Jakuslam/mesuring_temperature_distance_by_Arduino/držák na měřiče/drzakNaMerice.3mf

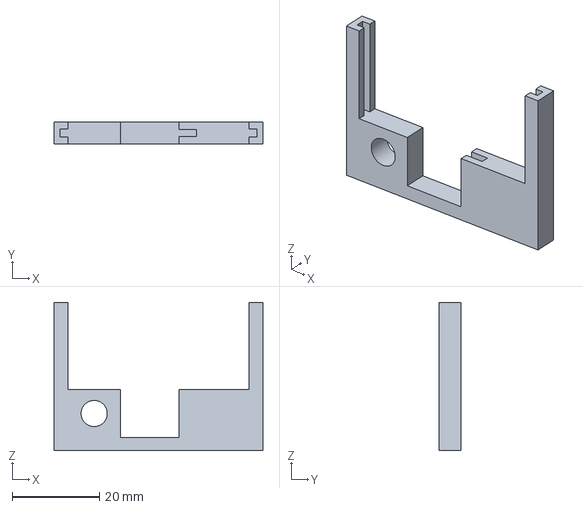
[picture p16: CAD file, 2024-05-21]
držák na měřiče/drzakNaMerice.3mf
48.0 x 5.00 x 34.0 mm
