Jakuslam/mesuring_temperature_distance_by_Arduino/měřící přístroj - case/handle.3mf

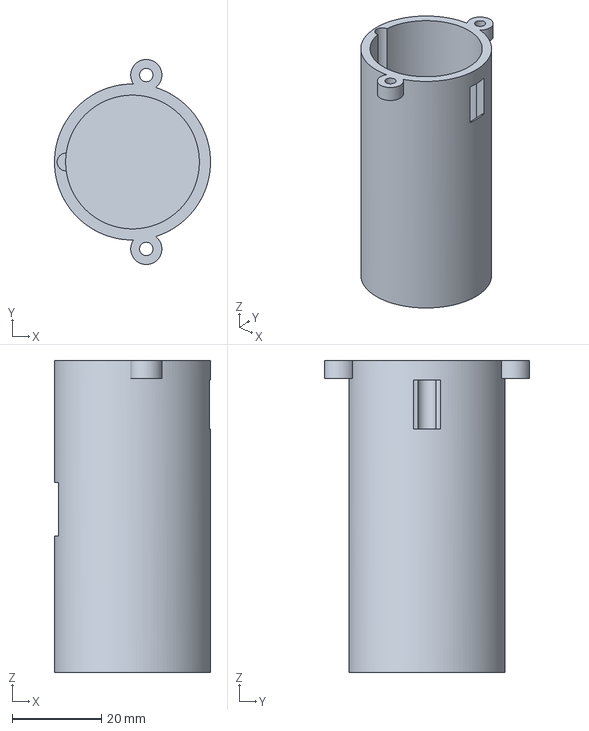
[picture p17: CAD file, 2024-05-21]
měřící přístroj - case/handle.3mf
35.0 x 46.0 x 70.0 mm
