Jakuslam/mesuring_temperature_distance_by_Arduino/Podložka pro dírky/Drawing1.stl

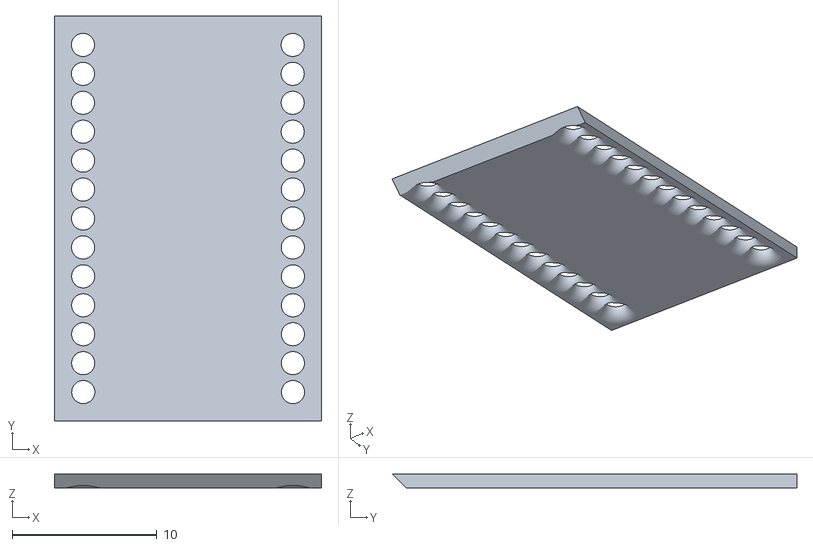
[picture p18: CAD file, 2023-10-13]
Podložka pro dírky/Drawing1.stl
18.5 x 28.0 x 1
