Jakuslam/mesuring_temperature_distance_by_Arduino/držák na měřiče/Drawing1.3mf

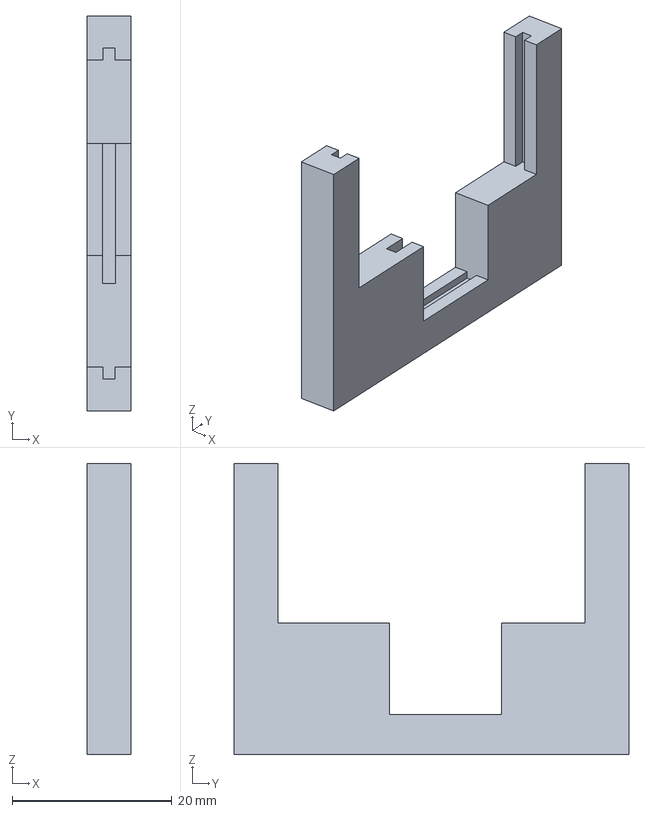
[picture p19: CAD file, 2023-09-24]
držák na měřiče/Drawing1.3mf
5.50 x 49.5 x 36.5 mm
