Jakuslam/mesuring_temperature_distance_by_Arduino/měřící přístroj - case/zkusebni otvory pro HC.stl

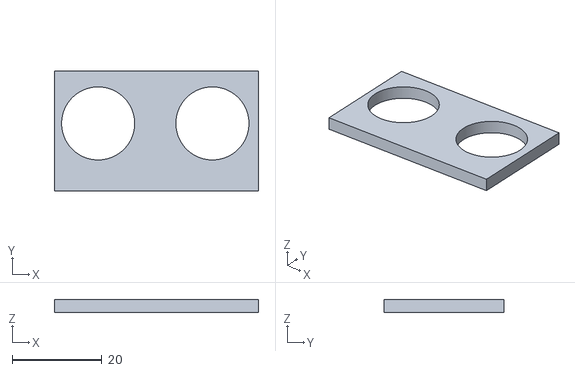
[picture p20: CAD file, 2024-05-21]
měřící přístroj - case/zkusebni otvory pro HC.stl
45.5 x 26.9 x 3.00
