Jakuslam/mesuring_temperature_distance_by_Arduino/měřící přístroj - case/vršek.3mf

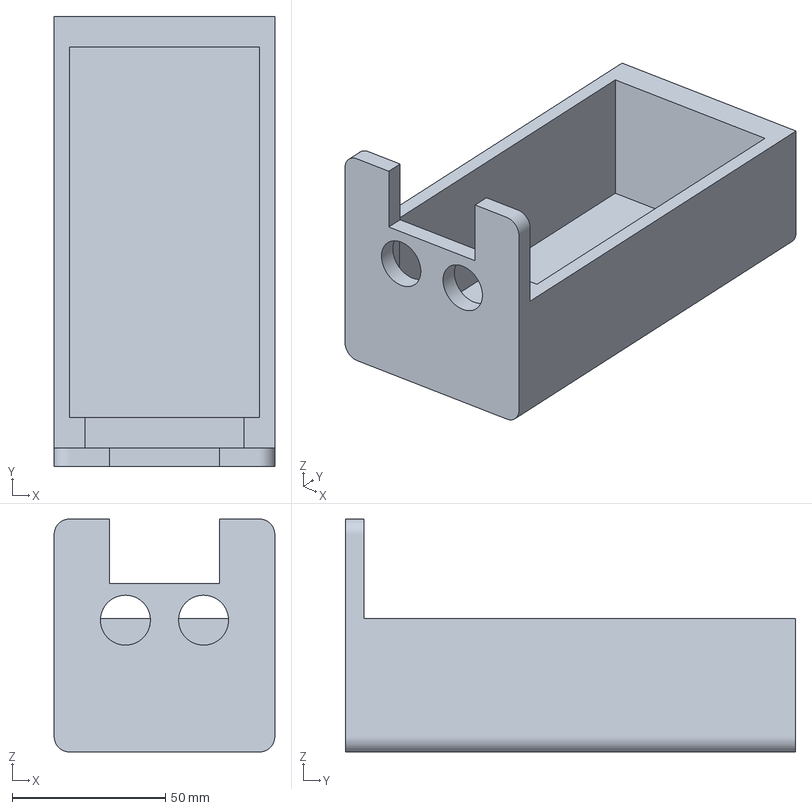
[picture p21: CAD file, 2024-05-21]
měřící přístroj - case/vršek.3mf
72.0 x 146.8 x 76.0 mm
