Jakuslam/mesuring_temperature_distance_by_Arduino/měřící přístroj - case/Vnitřek.3mf

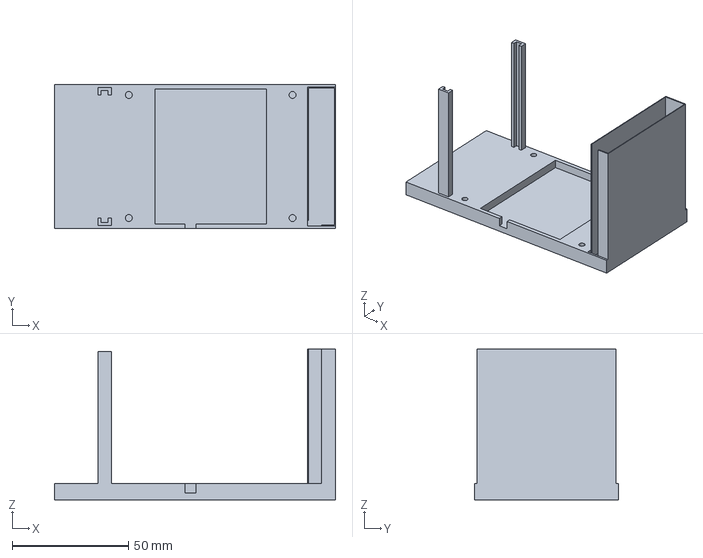
[picture p22: CAD file, 2024-05-21]
měřící přístroj - case/Vnitřek.3mf
121.0 x 62.0 x 65.0 mm
