Jakuslam/mesuring_temperature_distance_by_Arduino/měřící přístroj - case/Stojanek.3mf

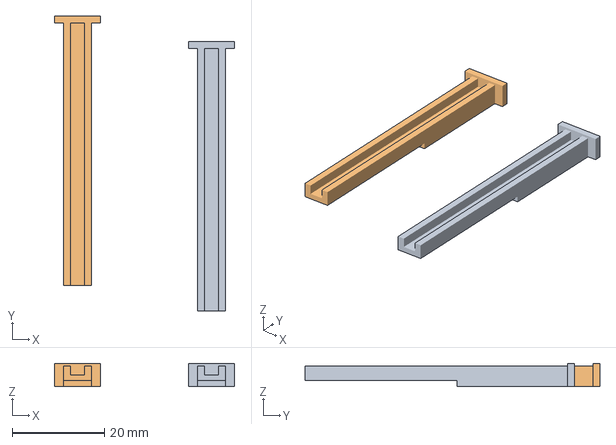
[picture p23: CAD file, 2024-05-21]
měřící přístroj - case/Stojanek.3mf
39.1 x 64.0 x 5.00 mm
Stojanek.stl x 2
