Jakuslam/mesuring_temperature_distance_by_Arduino/měřící přístroj - case/case.3mf

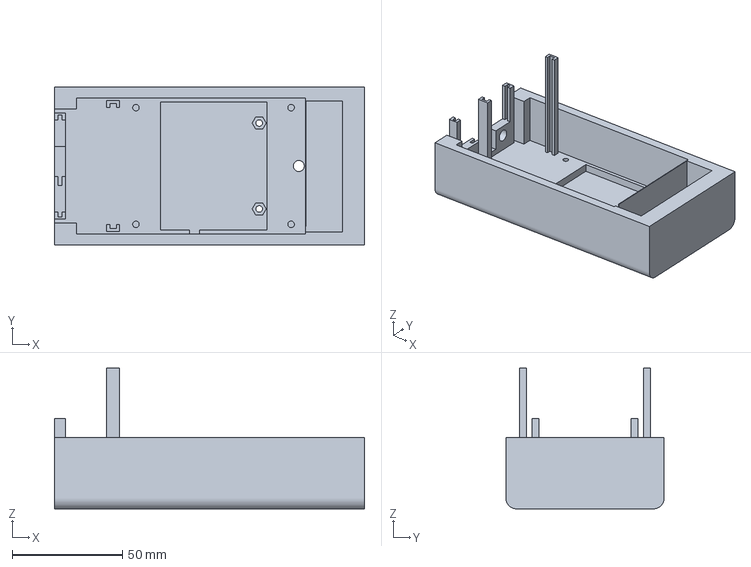
[picture p24: CAD file, 2024-05-21]
měřící přístroj - case/case.3mf
140.8 x 72.0 x 64.0 mm
