Jakuslam/mesuring_temperature_distance_by_Arduino/(list of files, cad)

Other CAD files:
Podložka pro dírky/Drawing1.dwg
držák na měřiče/Drawing1.dwg
držák na měřiče/Drawing1.stl
měřící přístroj - case/Stojanek.stl
měřící přístroj - case/Vnitřek.dwg
měřící přístroj - case/Vnitřek.stl
měřící přístroj - case/case.dwg
měřící přístroj - case/case.stl
měřící přístroj - case/handle.stl
měřící přístroj - case/vršek.stl
