Jakuslam/mesuring_temperature_distance_by_Arduino/(commit log)

2023-09-24 sloučení do všech podkladů
    [Drawing1.3mf, Drawing1.dwg, Drawing1.stl]
2023-10-13 rozsireni seminarky
    [Drawing1.dwg, Drawing1.stl]
2024-05-21 finall version
    [Drawing1.dwg, Drawing1.stl, Stojanek.3mf, Stojanek.stl, Vnitřek.3mf, Vnitřek.dwg, Vnitřek.stl, case.3mf]
